abel-msk/Backup-UPS-12v-Module/Backup UPS 12v Module.kicad_pcb

## KiCad design Backup UPS 12v Module.kicad_pcb (2026-11-10)

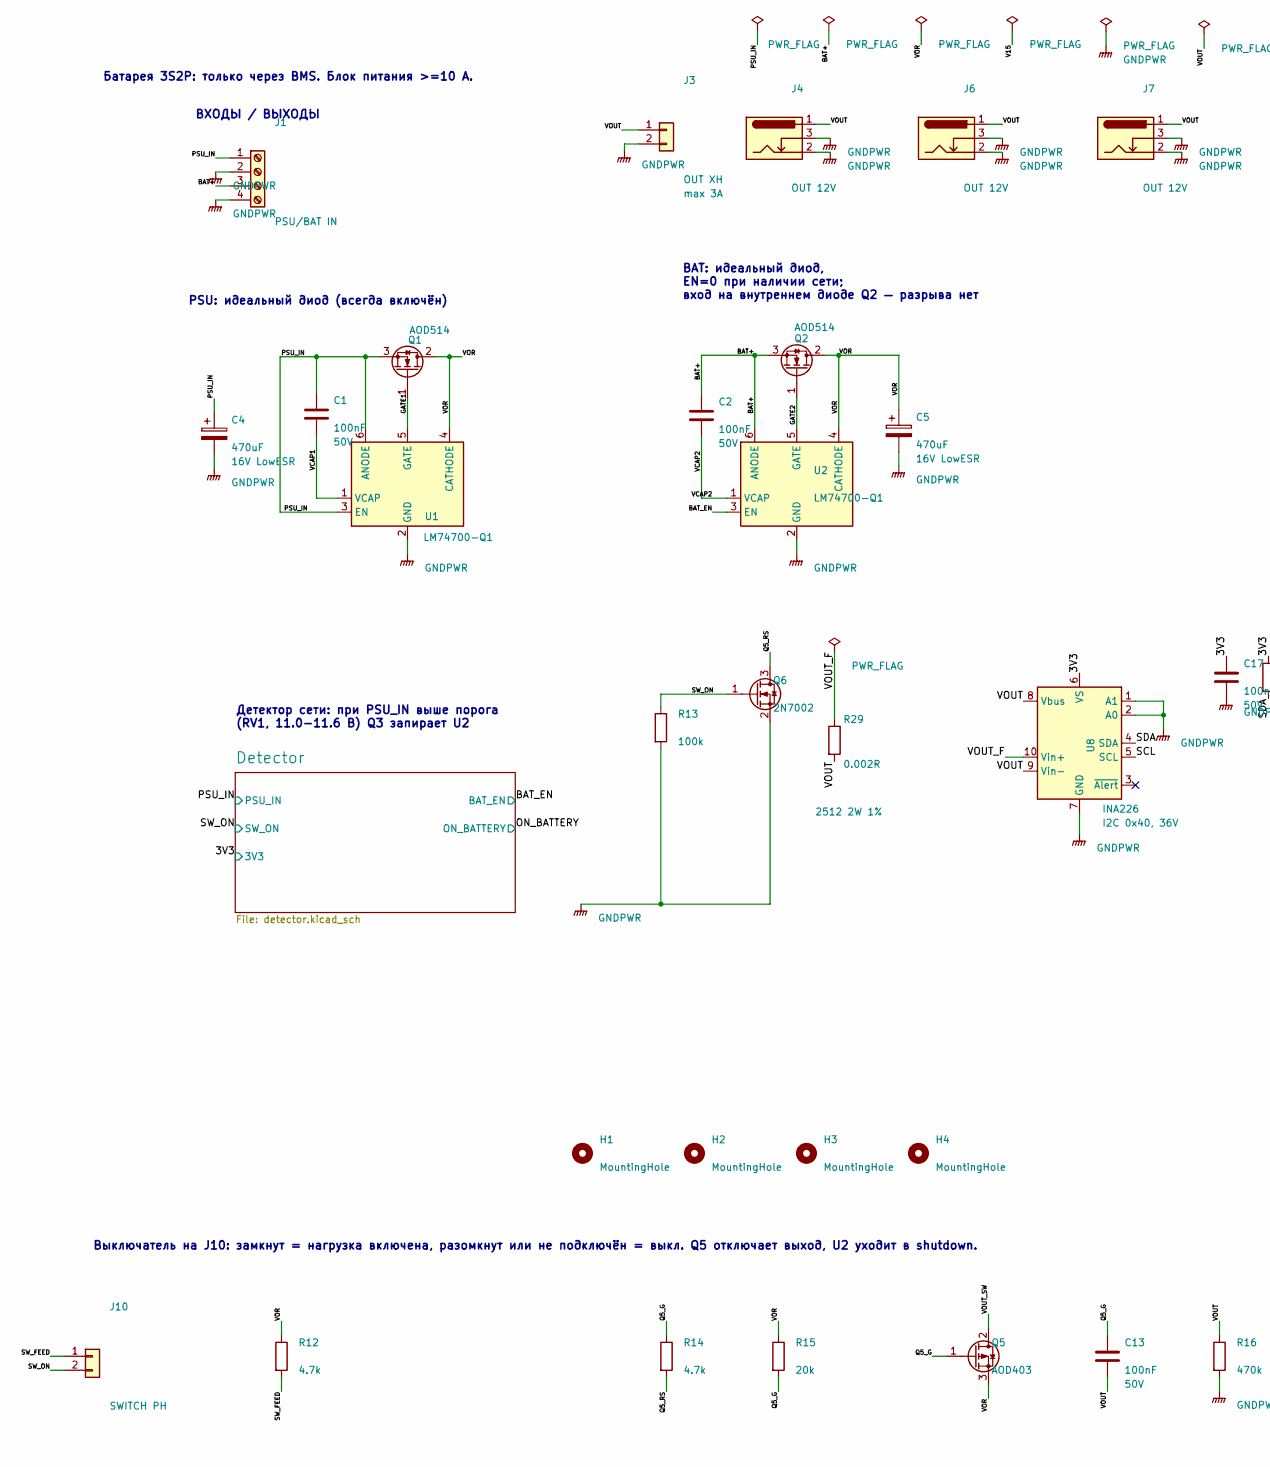
[picture p2: schematic Backup UPS 12v Module.kicad_sch, part in row 1, column 1]

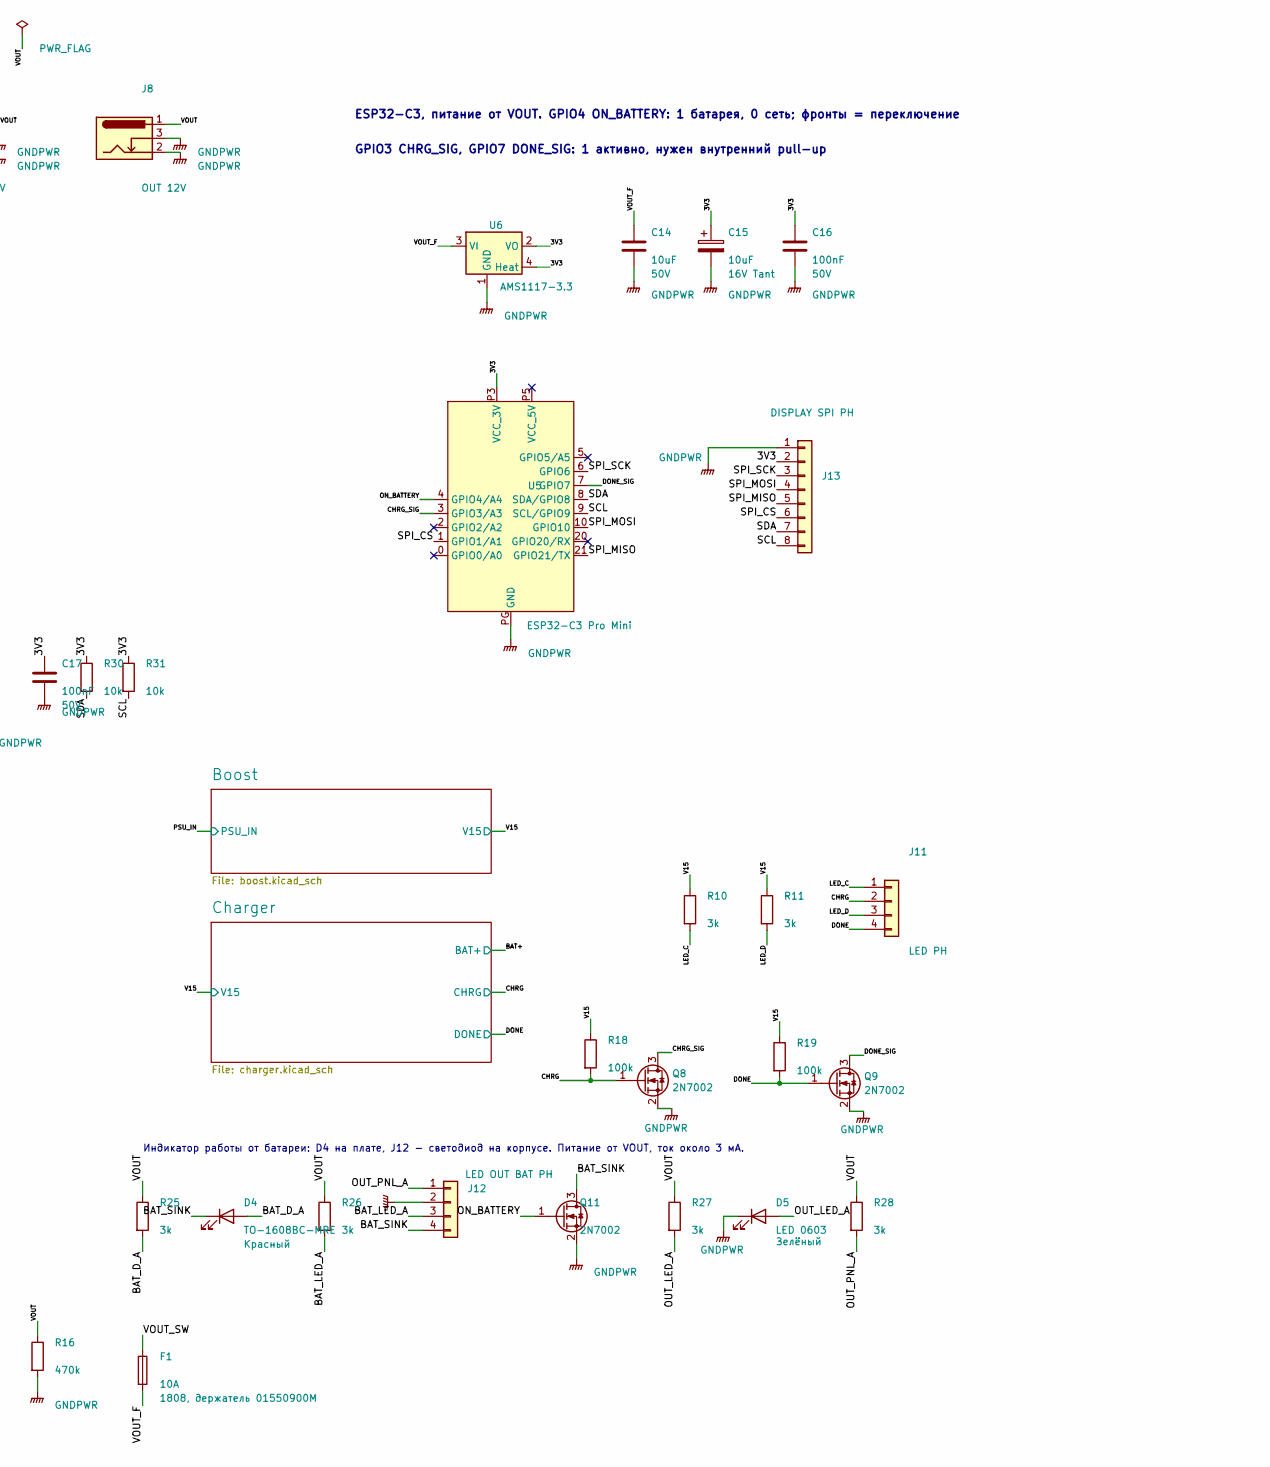
[picture p3: schematic Backup UPS 12v Module.kicad_sch, part in row 1, column 2]

Parts:
C1, C2, C13, C16, C17: 100nF; C_0805_2012Metric
C4, C5: 470uF; CP_Radial_D8.0mm_P3.50mm
C14: 10uF; C_1206_3216Metric
C15: 10uF; CP_EIA-3216-18_Kemet-A
D4: TO-1608BC-MRE; LED_0603_1608Metric; MPN TO-1608BC-MRE
D5: LED 0603; LED_0603_1608Metric
F1: 10A; Fuseholder_1808_SMD_Littelfuse_01550900; MPN 01550900M + 0451010
H1, H2, H3, H4: MountingHole; MountingHole_3.5mm_Pad_TopBottom
J1: PSU/BAT IN; ScrewTerminal_HB762_7.62_4P
J3: OUT XH; JST_XH_B2B-XH-A_1x02_P2.50mm_Vertical; MPN B2B-XH-A
J4, J6, J7, J8: OUT 12V; BarrelJack_Horizontal
J10: SWITCH PH; JST_PH_B2B-PH-K_1x02_P2.00mm_Vertical; MPN B2B-PH-K
J11: LED PH; JST_PH_B4B-PH-K_1x04_P2.00mm_Vertical; MPN B4B-PH-K
J12: LED OUT BAT PH; JST_PH_B4B-PH-K_1x04_P2.00mm_Vertical
J13: DISPLAY SPI PH; JST_PH_B8B-PH-K_1x08_P2.00mm_Vertical
Q1, Q2: AOD514; TO-252-2; MPN AOD514
Q5: AOD403; TO-252-2; MPN AOD403
Q6, Q8, Q9, Q11: 2N7002; SOT-23; MPN 2N7002LT1G
R10, R11, R25, R26, R27, R28: 3k; R_0603_1608Metric
R12, R14: 4.7k; R_0603_1608Metric
R13, R18, R19: 100k; R_0805_2012Metric
R15: 20k; R_0603_1608Metric
R16: 470k; R_0805_2012Metric
R29: 0.002R; R_2512_6332Metric_Pad1.40x3.35mm_HandSolder
R30, R31: 10k; R_0805_2012Metric
U1, U2: LM74700-Q1; SOT-23-6; MPN LM74700QDBVRQ1
U5: ESP32-C3 Pro Mini; ESP32-C3_Pro_mini_pin
U6: AMS1117-3.3; SOT-223; MPN AMS1117-3.3
U8: INA226; TSSOP-10_3x3mm_P0.5mm; MPN INA226AIDGSR

Connections:
/3V3: C15.1, C16.1, C17.1, J13.2, R30.1, R31.1, U5.P3 (VCC_3V), U6.2 (VO), U6.4 (Heat), U8.6 (VS); also elsewhere on the board
/BAT+: C2.1, J1.3, Q2.3 (S), U2.6 (ANODE); also elsewhere on the board
/BAT_D_A: D4.2 (A), R25.2
/BAT_EN: U2.3 (EN); also elsewhere on the board
/BAT_LED_A: J12.3, R26.2
/BAT_SINK: D4.1 (K), J12.4, Q11.3 (D)
/CHRG: J11.2, Q8.1 (G), R18.2; also elsewhere on the board
/CHRG_SIG: Q8.3 (D), U5.3 (GPIO3/A3)
/DONE: J11.4, Q9.1 (G), R19.2; also elsewhere on the board
/DONE_SIG: Q9.3 (D), U5.7 (GPIO7)
/GATE1: Q1.1 (G), U1.5 (GATE)
/GATE2: Q2.1 (G), U2.5 (GATE)
/LED_C: J11.1, R10.2
/LED_D: J11.3, R11.2
/ON_BATTERY: Q11.1 (G), U5.4 (GPIO4/A4); also elsewhere on the board
/OUT_LED_A: D5.2 (A), R27.2
/OUT_PNL_A: J12.1, R28.2
/PSU_IN: C1.1, C4.1, J1.1, Q1.3 (S), U1.3 (EN), U1.6 (ANODE); also elsewhere on the board
/Q5_G: C13.1, Q5.1 (G), R14.1, R15.2
/Q5_RS: Q6.3 (D), R14.2
/SCL: J13.8, R31.2, U5.9 (SCL/GPIO9), U8.5 (SCL)
/SDA: J13.7, R30.2, U5.8 (SDA/GPIO8), U8.4 (SDA)
/SPI_CS: J13.6, U5.1 (GPIO1/A1)
/SPI_MISO: J13.5, U5.21 (GPIO21/TX)
/SPI_MOSI: J13.4, U5.10 (GPIO10)
/SPI_SCK: J13.3, U5.6 (GPIO6)
/SW_FEED: J10.1, R12.2
/SW_ON: J10.2, Q6.1 (G), R13.1; also elsewhere on the board
/V15: R10.1, R11.1, R18.1, R19.1; also elsewhere on the board
/VCAP1: C1.2, U1.1 (VCAP)
/VCAP2: C2.2, U2.1 (VCAP)
/VOR: C5.1, Q1.2 (D), Q2.2 (D), Q5.3 (S), R12.1, R15.1, U1.4 (CATHODE), U2.4 (CATHODE)
/VOUT: C13.2, J3.1, J4.1, J6.1, J7.1, J8.1, R16.1, R25.1, R26.1, R27.1, R28.1, R29.2, U8.8 (Vbus), U8.9 (Vin-)
/VOUT_F: C14.1, F1.2, R29.1, U6.3 (VI), U8.10 (Vin+)
/VOUT_SW: F1.1, Q5.2 (D)
GNDPWR: C4.2, C5.2, C14.2, C15.2, C16.2, C17.2, D5.1 (K), J1.2, J1.4, J3.2, J4.2, J4.3, J6.2, J6.3, J7.2, J7.3, J8.2, J8.3, J12.2, J13.1, Q6.2 (S), Q8.2 (S), Q9.2 (S), Q11.2 (S), R13.2, R16.2, U1.2 (GND), U2.2 (GND), U5.PG (GND), U6.1 (GND), U8.1 (A1), U8.2 (A0), U8.7 (GND); also elsewhere on the board

Notes on the sheet:
BAT: идеальный диод, EN=0 при наличии сети; вход на внутреннем диоде Q2 — разрыва нет
ВХОДЫ / ВЫХОДЫ
Индикатор работы от батареи: D4 на плате, J12 - светодиод на корпусе. Питание от VOUT, ток около 3 мА.
Батарея 3S2P: только через BMS. Блок питания >=10 А.
PSU: идеальный диод (всегда включён)
Выключатель на J10: замкнут = нагрузка включена, разомкнут или не подключён = выкл. Q5 отключает выход, U2 уходит в shutdown.
ESP32-C3, питание от VOUT. GPIO4 ON_BATTERY: 1 батарея, 0 сеть; фронты = переключение
Детектор сети: при PSU_IN выше порога (RV1, 11.0-11.6 В) Q3 запирает U2
GPIO3 CHRG_SIG, GPIO7 DONE_SIG: 1 активно, нужен внутренний pull-up

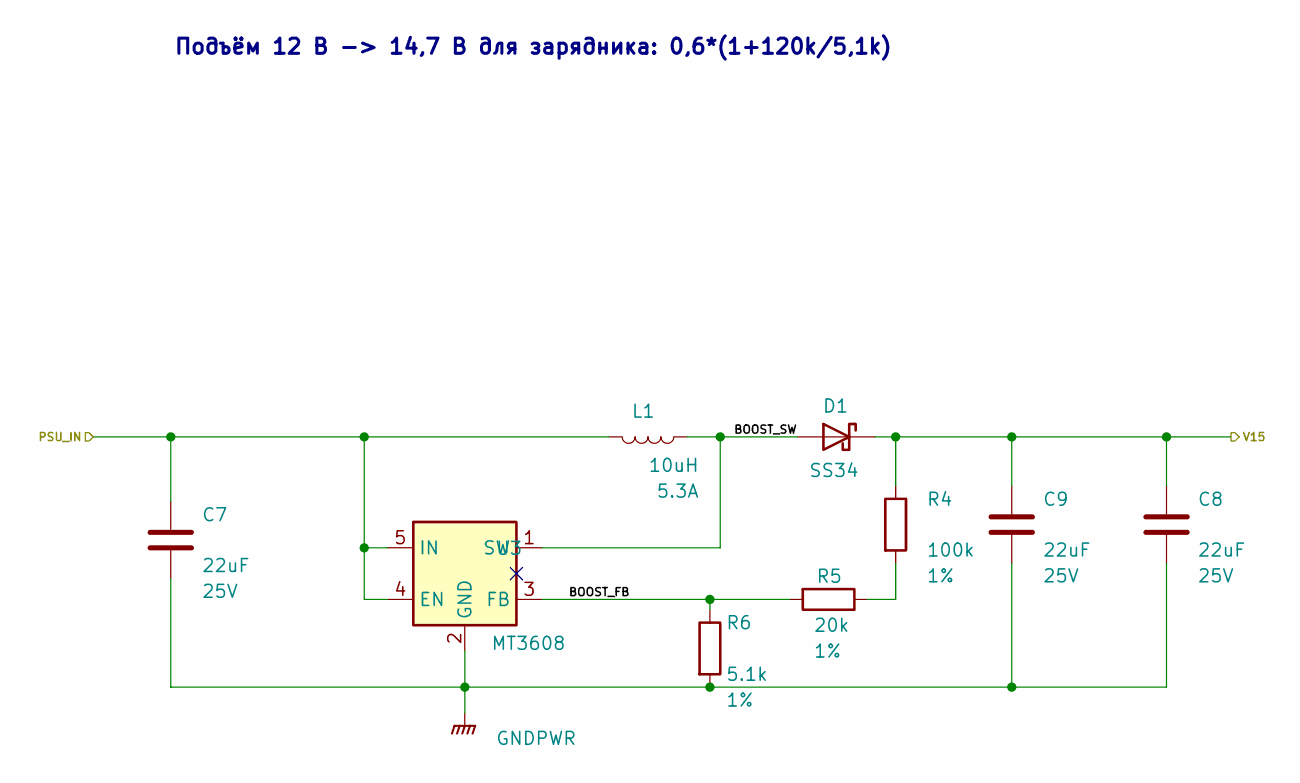
[picture p4: schematic boost.kicad_sch, Boost 12 V -> 14.7 V (charger supply)]

Parts:
C7, C8, C9: 22uF; C_1206_3216Metric
D1: SS34; D_SMA; MPN SS34
L1: 10uH; L_Molded_0650_7.5x6.6_H5.0
R4: 100k; R_0805_2012Metric
R5: 20k; R_0805_2012Metric
R6: 5.1k; R_0805_2012Metric
U3: MT3608; SOT-23-6; MPN MT3608

Connections:
/Boost/BOOST_FB: R5.2, R6.1, U3.3 (FB)
/Boost/BOOST_SW: D1.2 (A), L1.2, U3.1 (SW)
/PSU_IN: C7.1, L1.1, U3.4 (EN), U3.5 (IN); also elsewhere on the board
/V15: C8.1, C9.1, D1.1 (K), R4.1; also elsewhere on the board
GNDPWR: C7.2, C8.2, C9.2, R6.2, U3.2 (GND); also elsewhere on the board
unnamed: R4.2, R5.1

Notes on the sheet:
Подъём 12 В -> 14,7 В для зарядника: 0,6*(1+120k/5,1k)

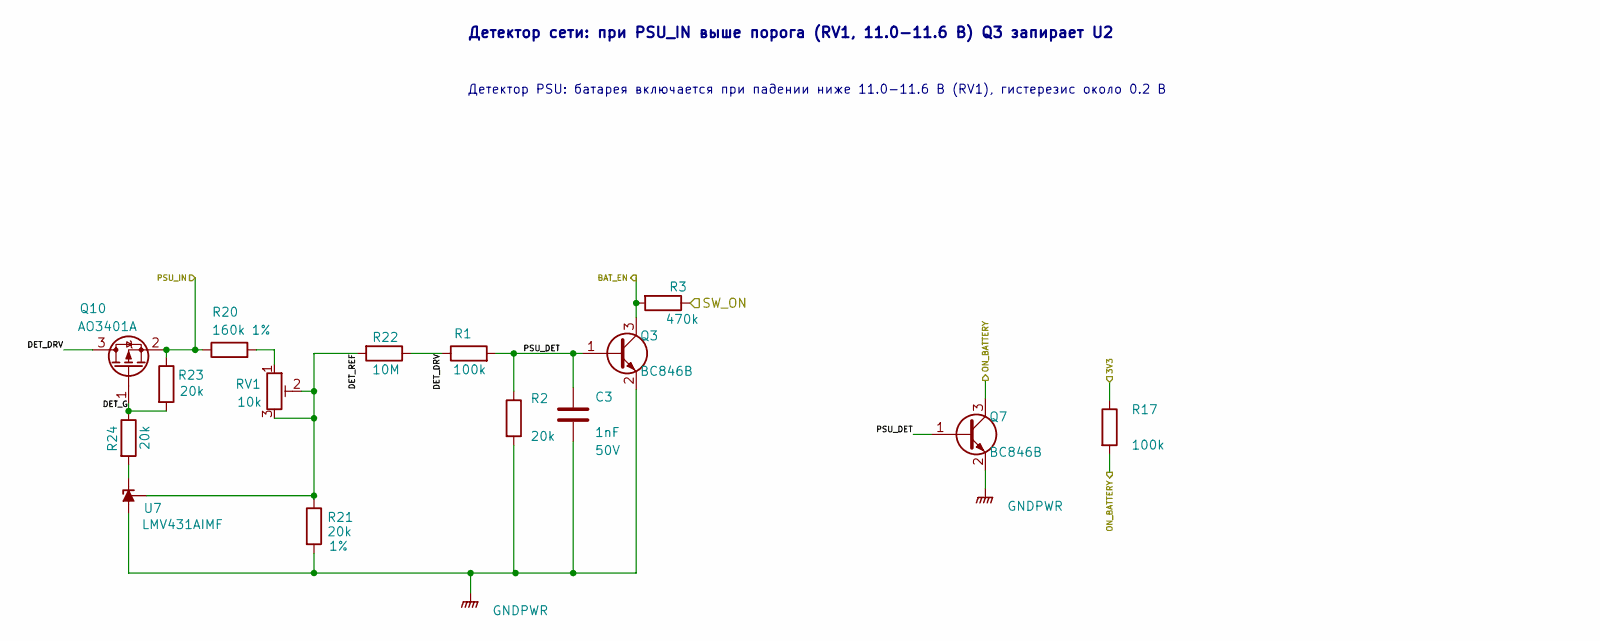
[picture p5: schematic detector.kicad_sch, Mains detector: threshold and switchover control]

Parts:
C3: 1nF; C_0603_1608Metric
Q3, Q7: BC846B; SOT-23; MPN BC846B
Q10: AO3401A; SOT-23; MPN AO3401A
R1, R17: 100k; R_0805_2012Metric
R2, R24: 20k; R_0603_1608Metric
R3: 470k; R_0805_2012Metric
R20: 160k; R_0805_2012Metric
R21: 20k; R_0805_2012Metric
R22: 10M; R_0805_2012Metric_Pad1.20x1.40mm_HandSolder
R23: 20k; R_0805_2012Metric_Pad1.20x1.40mm_HandSolder
RV1: 10k; Potentiometer_Bourns_3296W_Vertical; MPN 3296W-103
U7: LMV431AIMF; SOT-23; MPN LMV431AIMF

Connections:
/3V3: R17.1; also elsewhere on the board
/BAT_EN: Q3.3 (C), R3.2; also elsewhere on the board
/Detector/DET_DRV: Q10.3 (D), R1.1, R22.1
/Detector/DET_G: Q10.1 (G), R23.2, R24.1
/Detector/DET_REF: R21.1, R22.2, RV1.2, RV1.3, U7.1 (REF)
/Detector/PSU_DET: C3.1, Q3.1 (B), Q7.1 (B), R1.2, R2.1
/ON_BATTERY: Q7.3 (C), R17.2; also elsewhere on the board
/PSU_IN: Q10.2 (S), R20.1, R23.1; also elsewhere on the board
/SW_ON: R3.1; also elsewhere on the board
GNDPWR: C3.2, Q3.2 (E), Q7.2 (E), R2.2, R21.2, U7.3 (A); also elsewhere on the board
unnamed: R20.2, RV1.1
unnamed: R24.2, U7.2 (K)

Notes on the sheet:
Детектор сети: при PSU_IN выше порога (RV1, 11.0-11.6 В) Q3 запирает U2
Детектор PSU: батарея включается при падении ниже 11.0-11.6 В (RV1), гистерезис около 0.2 В

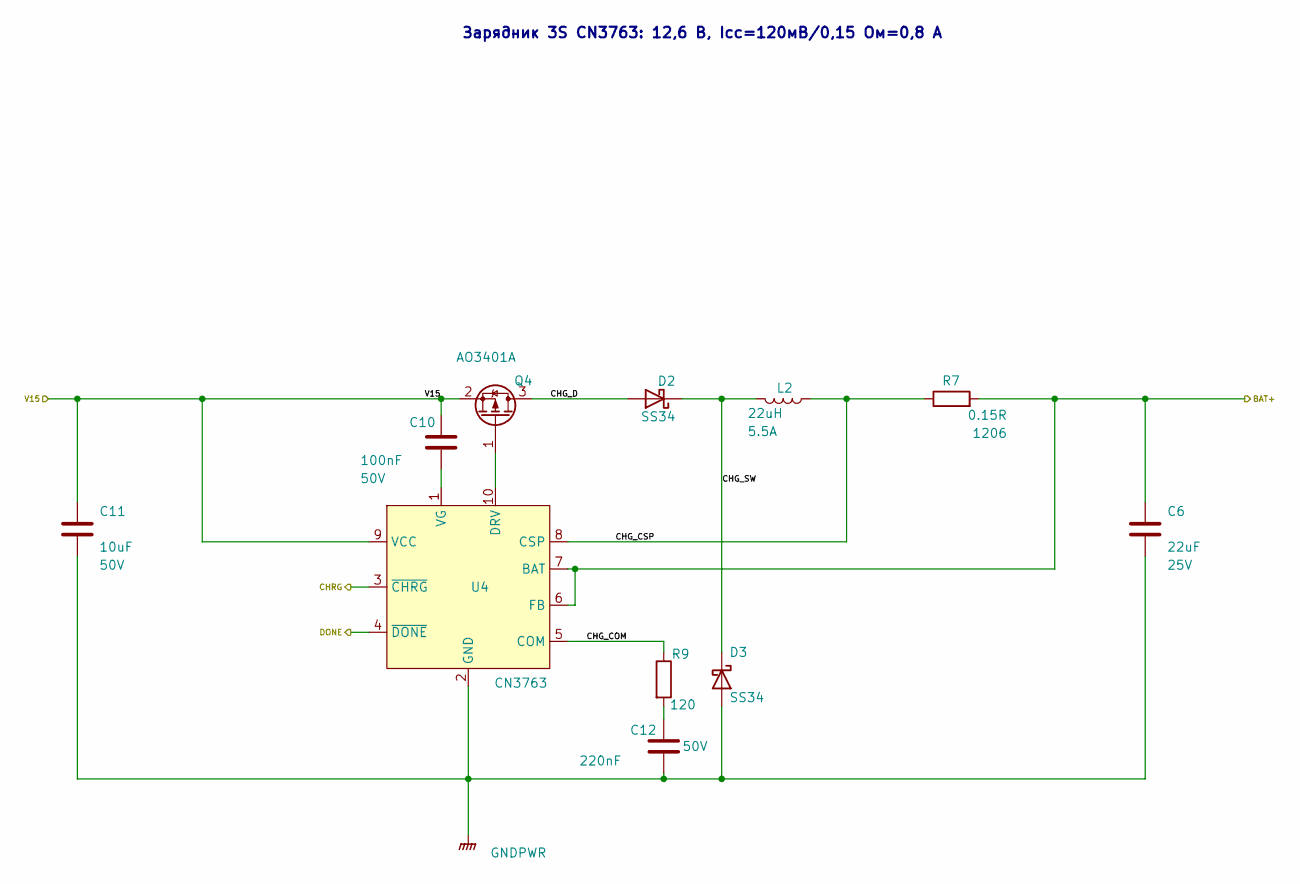
[picture p6: schematic charger.kicad_sch, CN3763 3S charger 12.6 V / 0.8 A]

Parts:
C6: 22uF; C_1206_3216Metric
C10: 100nF; C_0805_2012Metric
C11: 10uF; C_1206_3216Metric
C12: 220nF; C_0805_2012Metric
D2, D3: SS34; D_SMA; MPN SS34
L2: 22uH; L_Molded_1040_11.6x10.1_H4.0
Q4: AO3401A; SOT-23; MPN AO3401A
R7: 0.15R; R_1206_3216Metric
R9: 120; R_0603_1608Metric
U4: CN3763; SSOP-10_3.9x4.9mm_P1.00mm; MPN CN3763

Connections:
/BAT+: C6.1, R7.2, U4.6 (FB), U4.7 (BAT); also elsewhere on the board
/CHRG: U4.3 (~CHRG); also elsewhere on the board
/Charger/CHG_COM: R9.1, U4.5 (COM)
/Charger/CHG_CSP: L2.1, R7.1, U4.8 (CSP)
/Charger/CHG_D: D2.2 (A), Q4.3 (D)
/Charger/CHG_SW: D2.1 (K), D3.1 (K), L2.2
/DONE: U4.4 (~DONE); also elsewhere on the board
/V15: C10.1, C11.1, Q4.2 (S), U4.9 (VCC); also elsewhere on the board
GNDPWR: C6.2, C11.2, C12.2, D3.2 (A), U4.2 (GND); also elsewhere on the board
unnamed: C12.1, R9.2
unnamed: Q4.1 (G), U4.10 (DRV)
unnamed: C10.2, U4.1 (VG)

Notes on the sheet:
Зарядник 3S CN3763: 12,6 В, Icc=120мВ/0,15 Ом=0,8 А

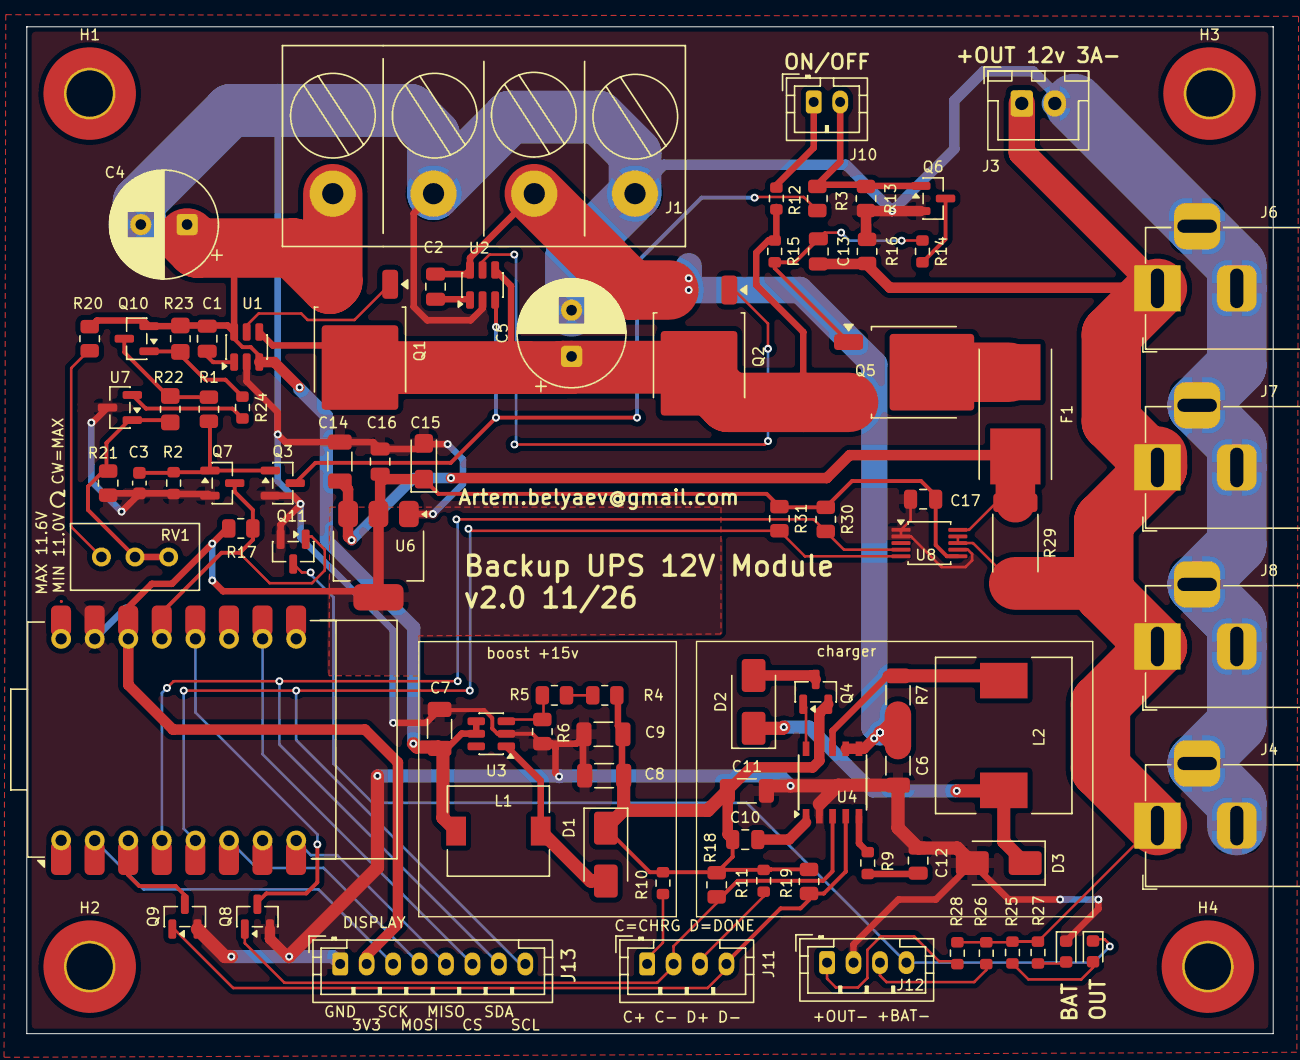
[picture p7: board Backup UPS 12v Module.kicad_pcb from above]

Board: 2 copper layers, 94.3 x 76.2 mm, 89 parts (0 on the bottom side), 52 nets.
