abel-msk/Backup-UPS-12v-Module/(commit log)

2026-11-08 Add 12 V UPS board with seamless PSU/3S battery switchover
    Ideal-diode OR of PSU and battery, CN3763 charger fed by an MT3608
    boost, high-side load switch controlled through a JST PH connector.
    Schematic and placement only; the board is not routed yet.
    [BOM.csv, Backup UPS 12v Module.kicad_pcb, Backup UPS 12v Module.kicad_sch]
2026-11-09 Rework detector, add indicators, output fuse and project background
    Continues the Backup power switch 12v Module project: the relay and
    firmware-driven switchover are replaced by ideal diodes and a hardware
    mains detector, and a boost stage lets the pack charge to 12.6 V.
    - Replace the mains detector with LMV431 + AO3401A, adjustable with RV1
    - Split the boost and charger circuits into hierarchical sheets
    - Add backup and load LEDs, panel outputs on J12, silkscreen legends
    - Add resettable fuse F1 (MF-R1100) to the schematic, not yet on the PCB
    - Document switchover logic and background, add 3D view and Russian README
    [BOM.csv, Backup UPS 12v Module.kicad_pcb, Backup UPS 12v Module.kicad_sch, boost.kicad_sch, charger.kicad_sch]
2026-11-09 Board v1.0 (11/26): output fuse holder and final footprints
    - Replace the PPTC with a 1808 fuse (10 A) in an SMD holder, routed between
    Q5 and VOUT
    - Use real-size footprints for L1, L2 and the HB762 terminal on J1
    - Change R20 and R21 to 0805
    - Add name, version and date to the silkscreen
    Not tested on hardware. DRC still reports 8 errors from earlier routing.
    [BOM.csv, Backup UPS 12v Module.kicad_pcb, Backup UPS 12v Module.kicad_sch, boost.kicad_sch, charger.kicad_sch]
2026-11-10 Board v2.0 (11/26): output monitor and display connector
    - Add INA226 output current and voltage monitor with a 2 mOhm shunt
    - Add 8-pin J13 connector with SPI and I2C for a display
    - Move threshold and switching parts to a Detector sheet
    - Switch dividers to 1% resistors, restore R7, resize parts to 0805
    [BOM.csv, Backup UPS 12v Module.kicad_pcb, Backup UPS 12v Module.kicad_sch, boost.kicad_sch, detector.kicad_sch]
2026-11-10 Fix the contact address typo on the silkscreen
    [Backup UPS 12v Module.kicad_pcb]
2026-11-10 Update the 3D board view for v2.0
2026-11-10 Refill all copper zones and update the 3D view
    [Backup UPS 12v Module.kicad_pcb]
